jibrailjasonlee/myo-hand/cad/Cover_Plate.STEP

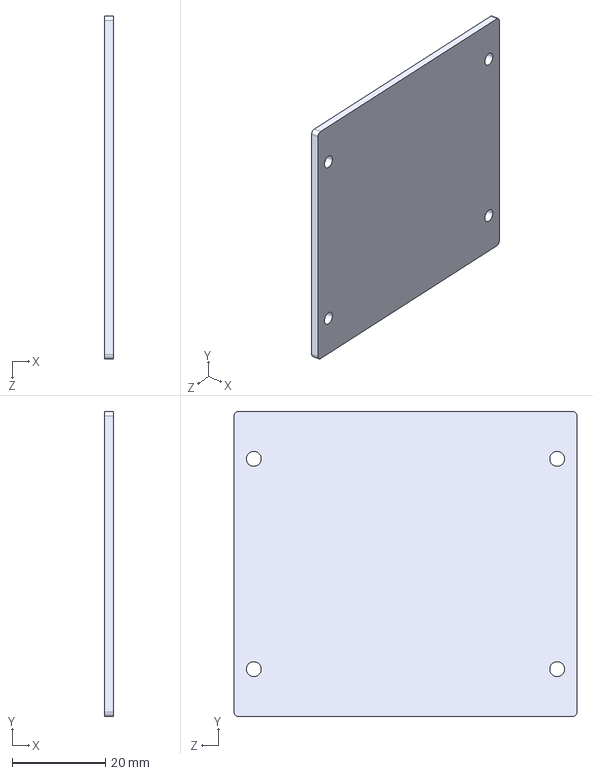
[picture p4: CAD file, 2026-11-04]
cad/Cover_Plate.STEP
2.00 x 65.6 x 73.7 mm
