jibrailjasonlee/myo-hand/cad/Palm_Base.STEP

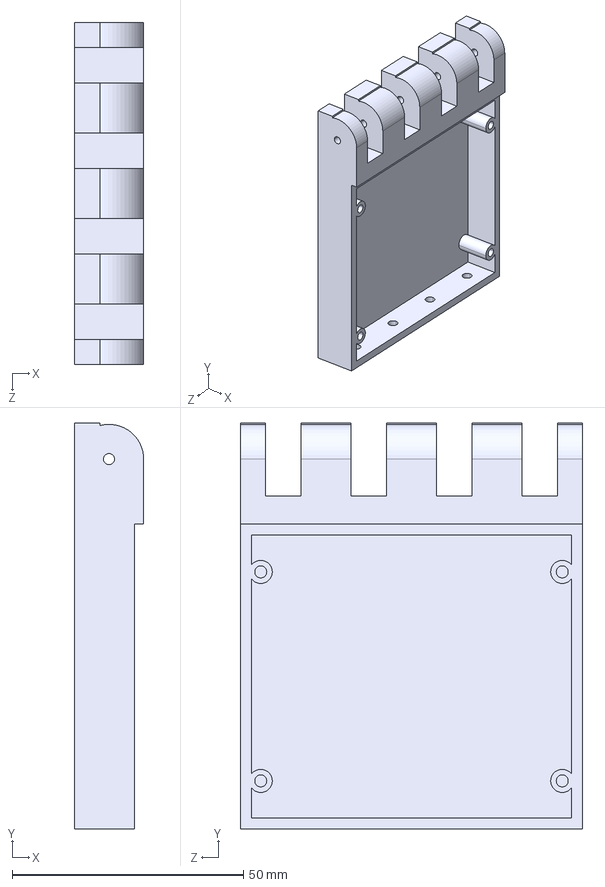
[picture p5: CAD file, 2026-11-03]
cad/Palm_Base.STEP
15.0 x 87.8 x 74.0 mm
