jibrailjasonlee/myo-hand/cad/Link1_Proximal.STEP

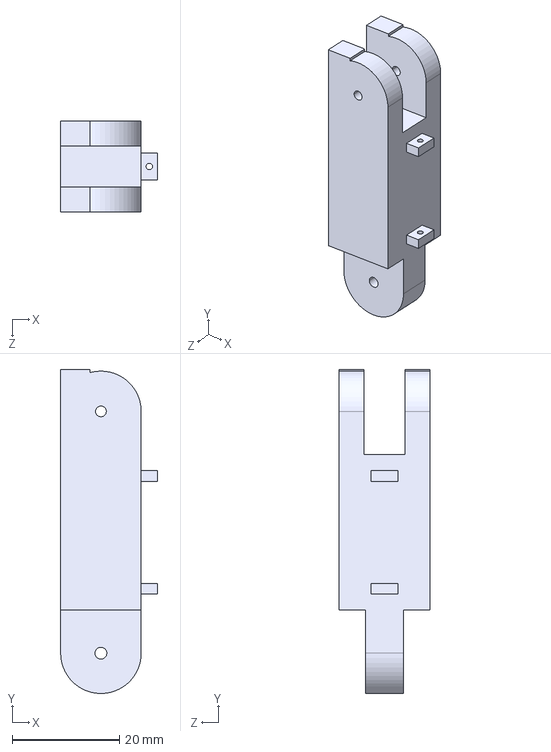
[picture p6: CAD file, 2026-10-27]
cad/Link1_Proximal.STEP
18.0 x 60.3 x 17.0 mm
