jibrailjasonlee/myo-hand/cad/Link2_Middle.STEP

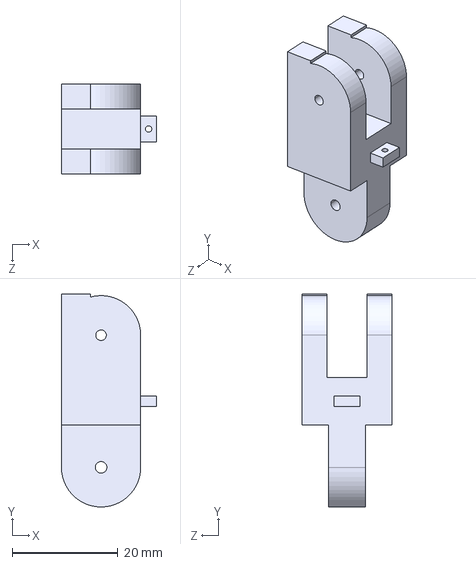
[picture p7: CAD file, 2026-10-27]
cad/Link2_Middle.STEP
18.0 x 40.3 x 17.0 mm
