jibrailjasonlee/myo-hand/cad/Link3_Tip.STEP

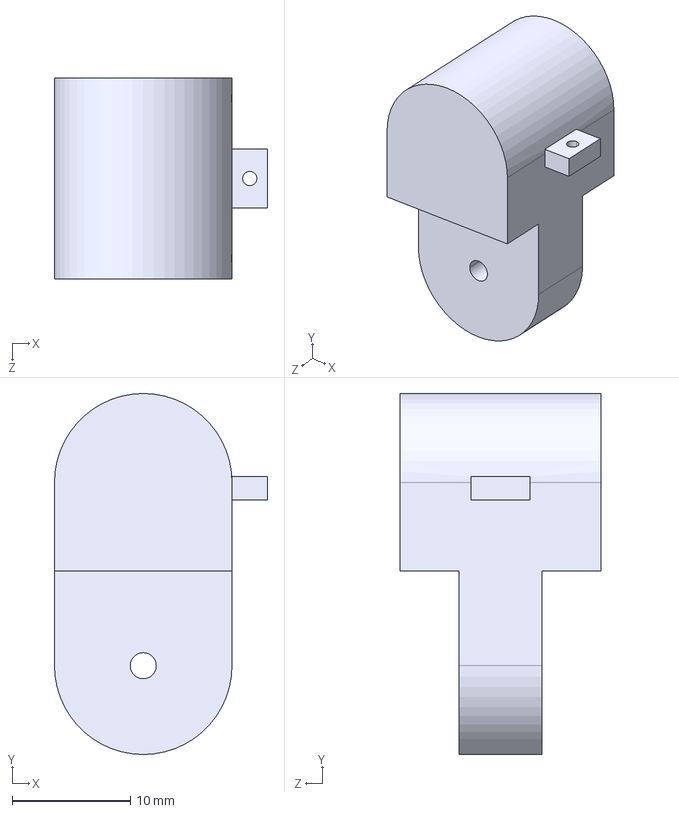
[picture p8: CAD file, 2026-10-26]
cad/Link3_Tip.STEP
18.0 x 30.5 x 17.0 mm
