jibrailjasonlee/myo-hand/(list of files, cad)

Other CAD files:
cad/skeleton_sketch.SLDPRT
cad/Cover_Plate.SLDPRT
cad/Link1_Proximal.SLDPRT
cad/Link2_Middle.SLDPRT
cad/Link3_Tip.SLDPRT
cad/Palm_Base.SLDPRT
