jibrailjasonlee/myo-hand/(commit log)

2026-10-18 cad: add Link1_Proximal body (60 x 15 x 17 mm stadium, mid-plane extrude)
    [Link1_Proximal.SLDPRT, Link1_Proximal.STEP, skeleton_sketch.SLDPRT]
2026-10-24 log link 1 joint cuts, flag tendon routing problem
2026-10-24 cut tongue, clevis slot and pin holes on link 1
    [Link1_Proximal.SLDPRT, Link1_Proximal.STEP]
2026-10-24 add tendon path script, switch cord to palm-face guides
2026-10-25 add cord guides to link 1
    [Link1_Proximal.SLDPRT, Link1_Proximal.STEP]
2026-10-25 fix print orientation note for link 1
2026-10-26 add link 2 (25 mm middle link)
    [Link2_Middle.SLDPRT, Link2_Middle.STEP]
2026-10-26 created link 3
    [Link3_Tip.SLDPRT, Link3_Tip.STEP]
2026-10-26 add bom
2026-10-27 model joint range, log extension stop
2026-10-27 created extension stops on joints
    [Link1_Proximal.SLDPRT, Link2_Middle.SLDPRT]
2026-10-27 updated step files
    [Link1_Proximal.SLDPRT, Link1_Proximal.STEP, Link2_Middle.STEP]
2026-10-28 created palm base
    [Palm_Base.SLDPRT]
2026-10-28 added step
    [Palm_Base.STEP]
2026-10-28 created the stop block and slots for palm
    [Palm_Base.SLDPRT, Palm_Base.STEP]
2026-11-03 added holes to palm base
    [Palm_Base.SLDPRT, Palm_Base.STEP]
2026-11-04 created cover plate
    [Cover_Plate.SLDPRT, Cover_Plate.STEP]
2026-11-04 log cover plate blank
